ipxe/keyflogger/circuit/snapeda/1001-011-01101--3DModel-STEP-1.STEP

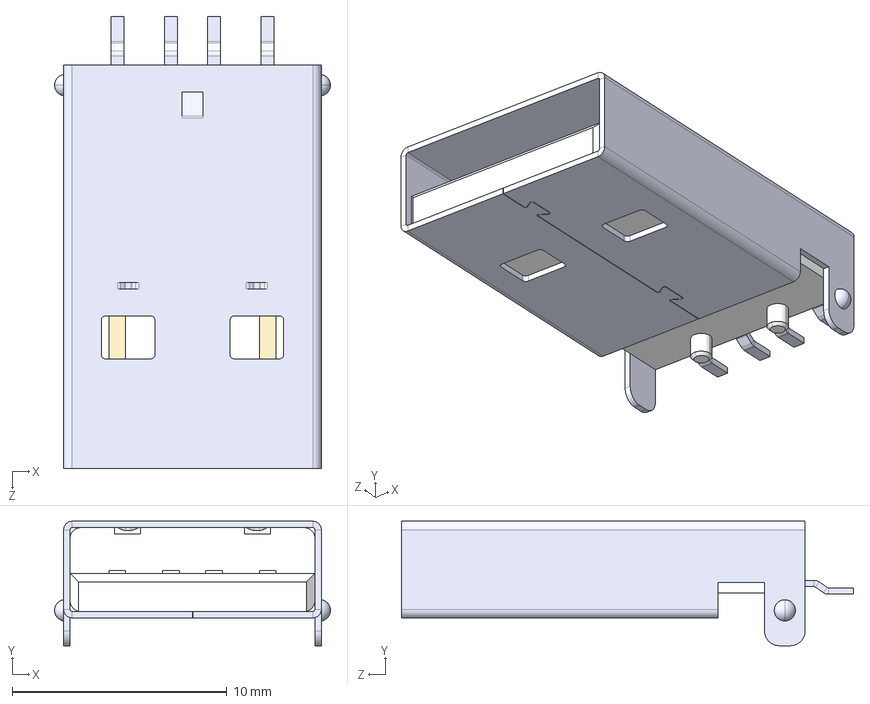
[picture p2: CAD file, 2021-04-07]
circuit/snapeda/1001-011-01101--3DModel-STEP-1.STEP
12.8 x 5.80 x 21.1 mm
