ipxe/keyflogger/circuit/snapeda/10118194-0001LF--3DModel-STEP-56544.STEP

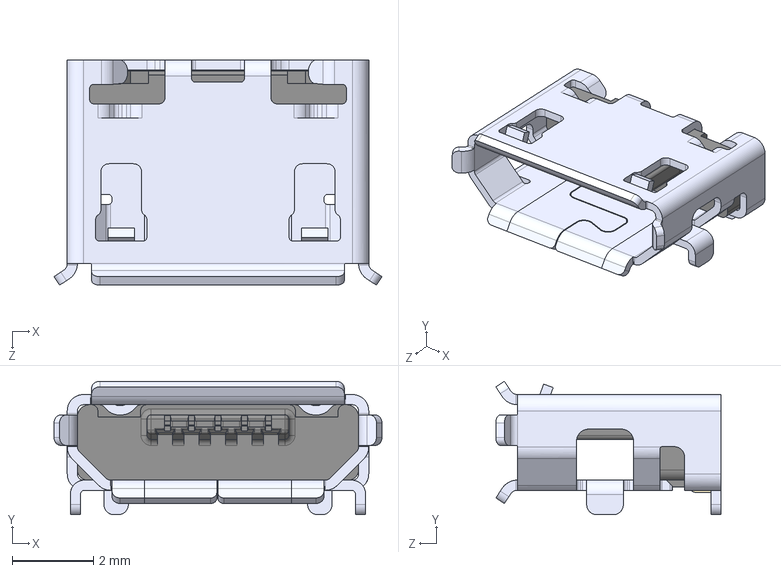
[picture p3: CAD file, 2021-03-25]
circuit/snapeda/10118194-0001LF--3DModel-STEP-56544.STEP
8.05 x 3.27 x 5.53 mm
