ipxe/keyflogger/circuit/keyflogger.kicad_pcb

## KiCad design circuit/keyflogger.kicad_pcb (2021-04-07)

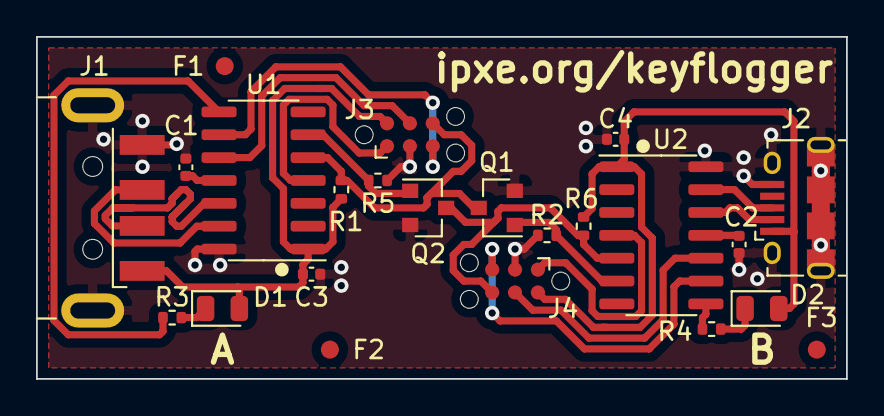
[picture p4: board keyflogger.kicad_pcb from above]

Board: 2 copper layers, 45.0 x 19.0 mm, 23 parts (0 on the bottom side), 23 nets.

Parts:
C1, C2, C3, C4: 470n; C_0402_1005Metric
D1, D2: Red 2mA; LED_0805_2012Metric
F1, F2, F3: Fiducial; Fiducial_1mm_Mask2mm
J1: USB_A; USB_A_CNCTech_1001-011-01101_Horizontal
J2: USB_B_Micro; USB_Micro-B_Amphenol_10118194_Horizontal
J3, J4: Conn_PIC_ICSP_ICD; Tag-Connect_TC2030-IDC-NL_2x03_P1.27mm_Vertical
Q1, Q2: 2N7002; SOT-23
R1, R2, R5, R6: 4K7; R_0402_1005Metric
R3, R4: 1K5; R_0402_1005Metric
U1, U2: PIC16F1454-IP; SOIC-14_3.9x8.7mm_P1.27mm

Connections:
/ICSPCLK1: J3.5, U1.9
/ICSPCLK2: J4.5, U2.9
/ICSPDAT1: J3.4, U1.10
/ICSPDAT2: J4.4, U2.10
/RX1: J3.6, Q1.3, R1.1, U1.5
/RX2: J4.6, Q2.3, R6.2, U2.5
/USB1_D+: J1.3, U1.13
/USB1_D-: J1.2, U1.12
/USB2_D+: J2.3, U2.13
/USB2_D-: J2.2, U2.12
/VUSB1: C1.1, U1.11
/VUSB2: C2.2, U2.11
/~LED1~: R3.2, U1.8
/~LED2~: R4.2, U2.8
/~MCLR~_VPP1: J3.1, U1.4
/~MCLR~_VPP2: J4.1, U2.4
/~TX1~: Q2.1, R5.2, U1.6
/~TX2~: Q1.1, R2.1, U2.6
GND: C1.2, C2.1, C3.2, C4.2, J1.4, J1.5, J2.5, J2.6, J3.3, J4.3, Q1.2, Q2.2, R2.2, R5.1, U1.14, U2.14
unnamed: D1.1, R3.1
unnamed: D2.1, R4.1
VDD1: C3.1, D1.2, J1.1, J3.2, R1.2, U1.1
VDD2: C4.1, D2.2, J2.1, J4.2, R6.1, U2.1
