ipxe/keyflogger/(commit log)

2021-02-24 circuit: Add git filter for kicad project files
    kicad project (.pro) files contain "last updated" fields that are
    irritating for version control. Mark these files to be filtered via
    the "kicad_project" filter, which can be defined using:
    git config --global filter.kicad_project.clean \
    "sed -e '/^update=/d; /^last_client=/d;'"
2021-02-24 circuit: Add initial sketch of circuit design
    [keyflogger.sch]
2021-02-25 circuit: Add diodes to prevent back powering via nMCLR
    [keyflogger.sch]
2021-02-25 circuit: Add MOSFETs to prevent back powering via SCL/SDA
    Add an I2C bidirectional level shifter (based on Philips application
    note AN97055) in each power domain in order to prevent back powering
    via the SCL/SDA pins.
    [keyflogger.sch]
2021-02-25 circuit: Label remaining signals of interest
    [keyflogger.sch]
2021-02-26 circuit: Reroute status LED to pin 7 to simplify PCB routing
    [keyflogger.sch]
2021-02-26 circuit: Use Tag-Connect for in-system programming connector
    [keyflogger.sch]
2021-02-26 circuit: Use USB A plug for one external connection
    The circuit should fit within an off-the-shelf USB key enclosure, and
    so can use a USB A plug and only one USB micro B socket.
    [keyflogger.sch]
2021-02-26 circuit: Add initial sketch of PCB layout
    [keyflogger.kicad_pcb]
2021-02-26 circuit: Add 1M resistors to prevent VDDx from floating
    Ensure that the I2C MOSFET gates are not left floating (and hence
    potentially failing to isolate) when power is disconnected.
    [keyflogger.kicad_pcb, keyflogger.sch]
2021-03-07 circuit: Use two separate ICSP connectors
    Programming two (identical) PICs in parallel via a single ICSP
    connector does work. However, the requirement to avoid back powering
    via the nMCLR/VPP pin is cumbersome to overcome: high-voltage
    programming requires the programmer to be able to drive nMCLR/VPP to
    at least 8.0V (thereby preventing the use of a common cathode diode)
    while low-voltage programming requires the programmer to be able to
    pull nMCLR/VPP down to 0V (thereby preventing the use of a common
    anode diode).
    Split out a separate ICSP connector for each PIC. Since there are now
    separate VDD pins for each ICSP connector, the VDD pins may now be
    connected to VDD1/VDD2, thereby allowi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
    [keyflogger.kicad_pcb, keyflogger.sch]
2021-03-07 circuit: Add front ground plane
    [keyflogger.kicad_pcb]
2021-03-25 firmware: Add stub firmware implementation
    Add a basic "hello world" firmware capable of enumerating as a USB HID
    device compatible with a boot keyboard, and sending (empty) HID
    reports.
2021-03-25 circuit: Switch to using the UART to provide the data channel
    The PICs do not provide internal pull-ups on the I2C SCL/SDA pins,
    which would increase the external component count for the data channel
    to 10 parts in total (4x MOSFETs, 4x pull-up resistors, 2x pull-down
    resistors).
    Switch to using the UART, which requires only 6 external components
    (2x MOSFETs, 2x pull-up resistors, 2x pull-down resistors) and has the
    advantage that the data channel may be snooped (or emulated) using an
    off-the-shelf USB TTL UART adapter.
    [keyflogger.kicad_pcb, keyflogger.sch]
2021-03-25 circuit: Add 3D model for micro USB connector
    [10118194-0001LF--3DModel-STEP-56544.STEP, keyflogger.kicad_pcb]
2021-03-25 circuit: Add 3D model for USB A connector
    [1001-011-01101--3DModel-STEP-56544.STEP, keyflogger.kicad_pcb]
2021-03-25 firmware: Allow status reporting via LED with a single instruction
    Redefine the status LED internal state to allow both activity and
    error status to be reported using a single "bsf" instruction, with an
    error now displayed as a series of slow blinks and taking priority
    over any concurrent activity blinks.
    [keyflogger.asm]
2021-03-25 firmware: Initialise status LED subsystem first
    The LED subsystem has no further dependencies and should therefore be
    initialised first, in order to allow subsequent subsystems to report
    errors.
    [keyflogger.asm]
2021-03-25 firmware: Use a UART transmit ring buffer
    Allow for the UART to be used for non-debug messages by providing a
    transmit ring buffer that can be filled without waiting for the
    transmission to complete.
    Rewrite USB debugging to use whole-line messages, in order to fit
    within the expected communication protocol.
2021-03-25 firmware: Add stub UART receive datapath
2021-04-02 firmware: Fill EP2/EP3 IN buffers via UART
    Accept commands comprising an initial "K" or "M" to select the
    keyboard or mouse endpoint, followed by sixteen hex digits to populate
    the corresponding HID report.
2021-04-04 firmware: Add interrupt OUT endpoints
2021-04-04 firmware: Zero-pad reports received via interrupt OUT endpoints
    USB HID reports delivered via an interrupt OUT endpoint include an
    initial report ID byte, if the device includes a report ID anywhere
    within its report descriptor. Report ID zero is reserved and may not
    be used.
    The Linux hidraw driver unconditionally requires an initial report ID
    byte in data written to /dev/hidrawN, with the documentation stating
    that this report ID byte should contain zero if the device does not
    use report IDs. The Linux implementation will therefore strip the
    initial byte written if and only if this byte has a value of zero.
    Assume that a seven-byte report received via an interrupt OUT endpoint
    has a mi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
2021-04-05 firmware: Refactor and reduce code duplication
    Separate out the code handling the inter-IC communication protocol
    from the UART and USB device driver code, and provide a shared
    function for refilling any of the interrupt endpoints.
2021-04-05 circuit: Update LED labels to reflect functional symmetry
    The firmware is identical on each side, and the device may be used in
    whichever orientation is more physically convenient. Update the LED
    labels to reflect this symmetry.
    [keyflogger.kicad_pcb]
2021-04-05 circuit: Automate generation of PCB fabrication files
2021-04-06 circuit: Add fiducial markers
    [keyflogger.kicad_pcb, keyflogger.sch]
2021-04-06 circuit: Add solder paste layer to fabrication outputs
2021-04-06 circuit: Add bill of materials
    [keyflogger.kicad_pcb, keyflogger.sch]
2021-04-06 circuit: Update bill of materials for Seeed OPL
    [keyflogger.sch]
2021-04-07 circuit: Add PCB assembly outputs
2021-04-07 circuit: Tidy up fabrication and assembly output files
2021-04-07 circuit: Clean up assembly diagram
    [keyflogger.kicad_pcb]
2021-04-07 circuit: Add title block to PCB diagrams
    [keyflogger.kicad_pcb]
2021-04-07 circuit: Add silkscreen orientation markers for PIC ICs
    [keyflogger.kicad_pcb]
2021-04-07 circuit: Update fabrication files to match Seeed guidelines
2021-04-07 circuit: Use updated SnapEDA model for USB A connector
    [1001-011-01101--3DModel-STEP-1.STEP, 1001-011-01101--3DModel-STEP-56544.STEP, keyflogger.kicad_pcb]
2021-05-25 firmware: Preserve all registers in uart_tx_sync
2021-05-25 firmware: Wait for transmitter to become idle in uart_tx_sync
    Ensure that data has been physically transmitted before returning from
    uart_tx_sync, to allow for use in situations where the CPU is about to
    enter sleep mode.
2021-05-25 firmware: Handle USB suspend
    Handle USB suspend by dropping to a minimal power state with all
    peripherals and interrupts disabled (other than the ability to detect
    USB bus activity).
